urjaman/frser-m328lpcspi/README.md

frser-m328lpcspi
================

Flashrom serprog device code for LPC/FWH + SPI on an atmega328p at 5V.

### Troubleshooting

Note that the flasher has a small interactive debug interface. This is
available on the serial terminal if a space character is sent.
Enter `?` to see available commands.
