urjaman/frser-m328lpcspi/hardware/schematic.png

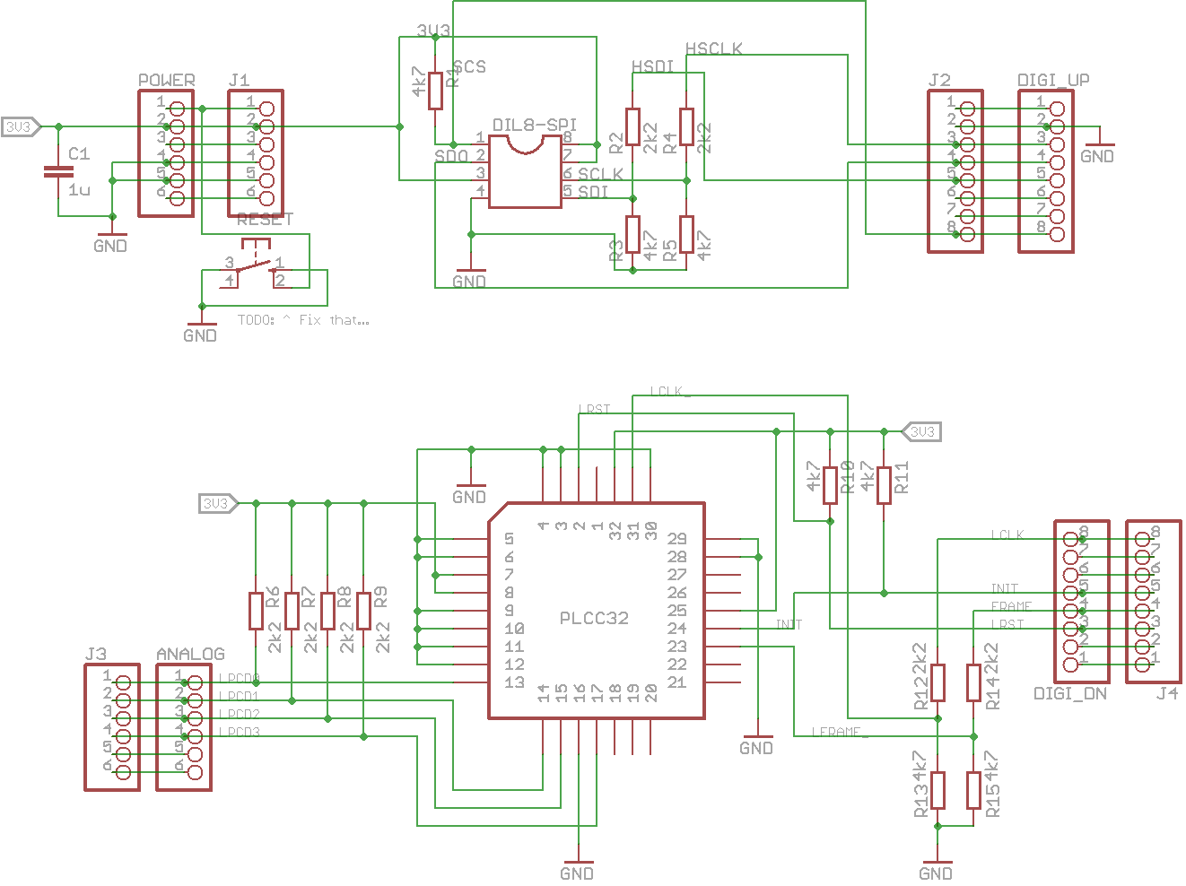
hardware/schematic.png
