urjaman/frser-m328lpcspi/hardware/duinolpcfwhspi.brd

## EAGLE design hardware/duinolpcfwhspi.brd (2015-04-25)

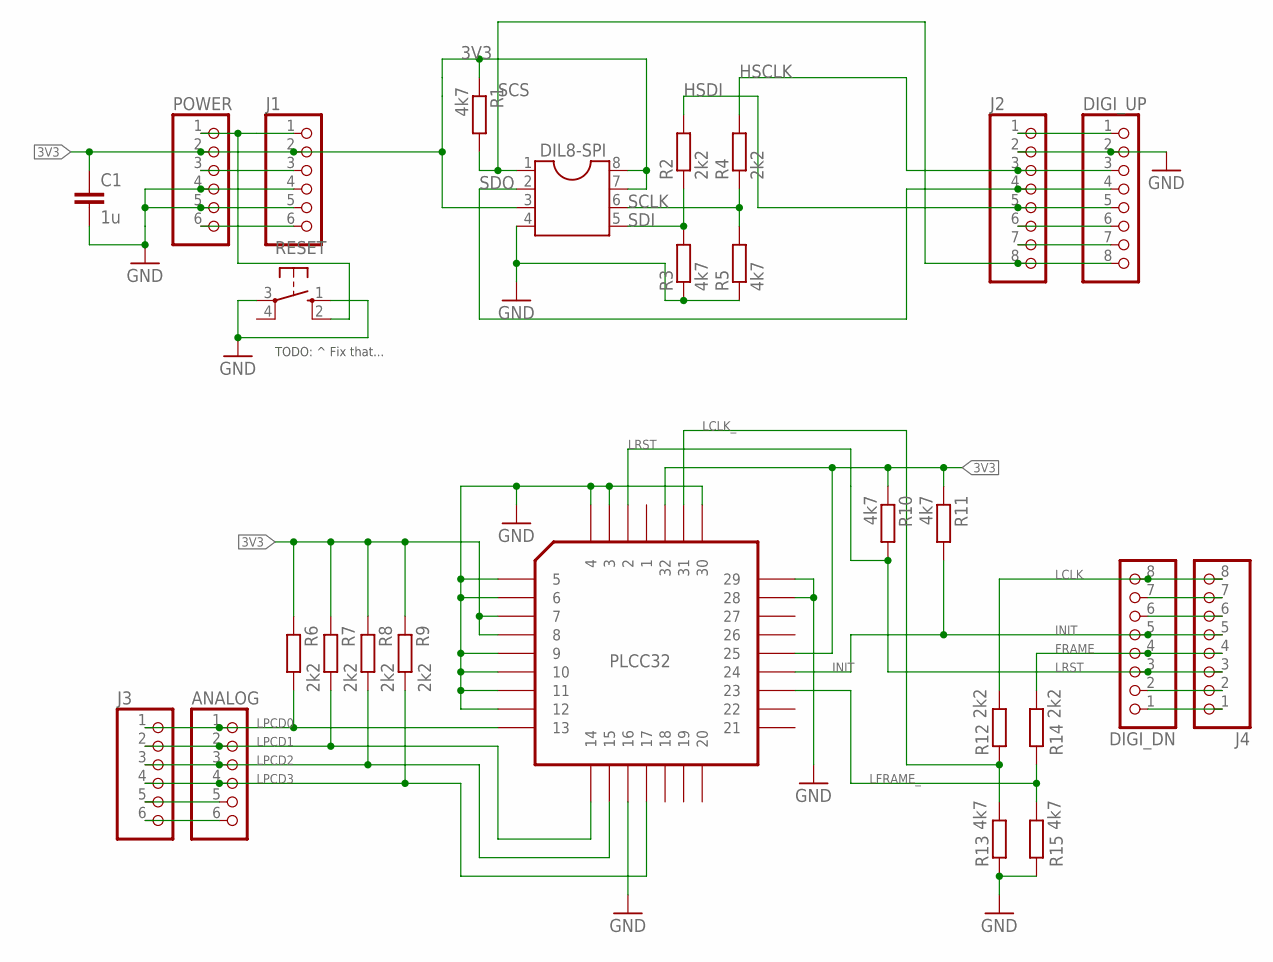
[picture p2: schematic duinolpcfwhspi.sch]

Parts:
ANALOG: PINHD-1X6; 1X06
C1: 1u; C025-025X050
DIGI_DN: PINHD-1X8TH; 1X08-TH
DIGI_UP: PINHD-1X8TH; 1X08-TH
DIL8-SPI: DIL8; DIL08
J1, J3: PINHD-1X6; 1X06
J2, J4: PINHD-1X8TH; 1X08-TH
PLCC32: PLCC32; PLCC-S32
POWER: PINHD-1X6; 1X06
R1, R3, R5, R10, R11, R13, R15: 4k7; 0207/2V
R2, R4, R6, R7, R8, R9, R12, R14: 2k2; 0207/2V
RESET: 10-XX; B3F-10XX

Connections:
3V3: C1.1, DIL8-SPI.3, DIL8-SPI.7, DIL8-SPI.8, J1.2, PLCC32.7, PLCC32.8, PLCC32.25, PLCC32.32, POWER.2, R1.1, R6.1, R7.1, R8.1, R9.1, R10.1, R11.1
5V0: J1.3, POWER.3
AREF: DIGI_UP.1, J2.1
FRAME: DIGI_DN.4, J4.4, R14.2
GND: C1.2, DIGI_UP.2, DIL8-SPI.4, J1.4, J1.5, J2.2, PLCC32.3, PLCC32.4, PLCC32.5, PLCC32.6, PLCC32.9, PLCC32.10, PLCC32.11, PLCC32.12, PLCC32.16, PLCC32.28, PLCC32.29, PLCC32.30, POWER.4, POWER.5, R3.1, R5.1, R13.1, R15.1, RESET.1 (S), RESET.3
HSCLK: DIGI_UP.3, J2.3, R4.2
HSDI: DIGI_UP.5, J2.5, R2.2
INIT: DIGI_DN.5, J4.5, PLCC32.24, R11.2
LCLK: DIGI_DN.8, J4.8, R12.2
LCLK_: PLCC32.31, R12.1, R13.2
LFRAME_: PLCC32.23, R14.1, R15.2
LPCD0: ANALOG.1, J3.1, PLCC32.13, R6.2
LPCD1: ANALOG.2, J3.2, PLCC32.14, R7.2
LPCD2: ANALOG.3, J3.3, PLCC32.15, R8.2
LPCD3: ANALOG.4, J3.4, PLCC32.17, R9.2
LRST: DIGI_DN.3, J4.3, PLCC32.2, R10.2
PB1: DIGI_UP.7, J2.7
PB2: DIGI_UP.6, J2.6
PC4: ANALOG.5, J3.5
PC5: ANALOG.6, J3.6
PD0: DIGI_DN.1, J4.1
PD1: DIGI_DN.2, J4.2
PD5: DIGI_DN.6, J4.6
PD6: DIGI_DN.7, J4.7
RESET: J1.1, POWER.1, RESET.2 (S1)
SCLK: DIL8-SPI.6, R4.1, R5.2
SCS: DIGI_UP.8, DIL8-SPI.1, J2.8, R1.2
SDI: DIL8-SPI.5, R2.1, R3.2
SDO: DIGI_UP.4, DIL8-SPI.2, J2.4
VIN: J1.6, POWER.6

Notes on the sheet:
TODO: ^ Fix that...

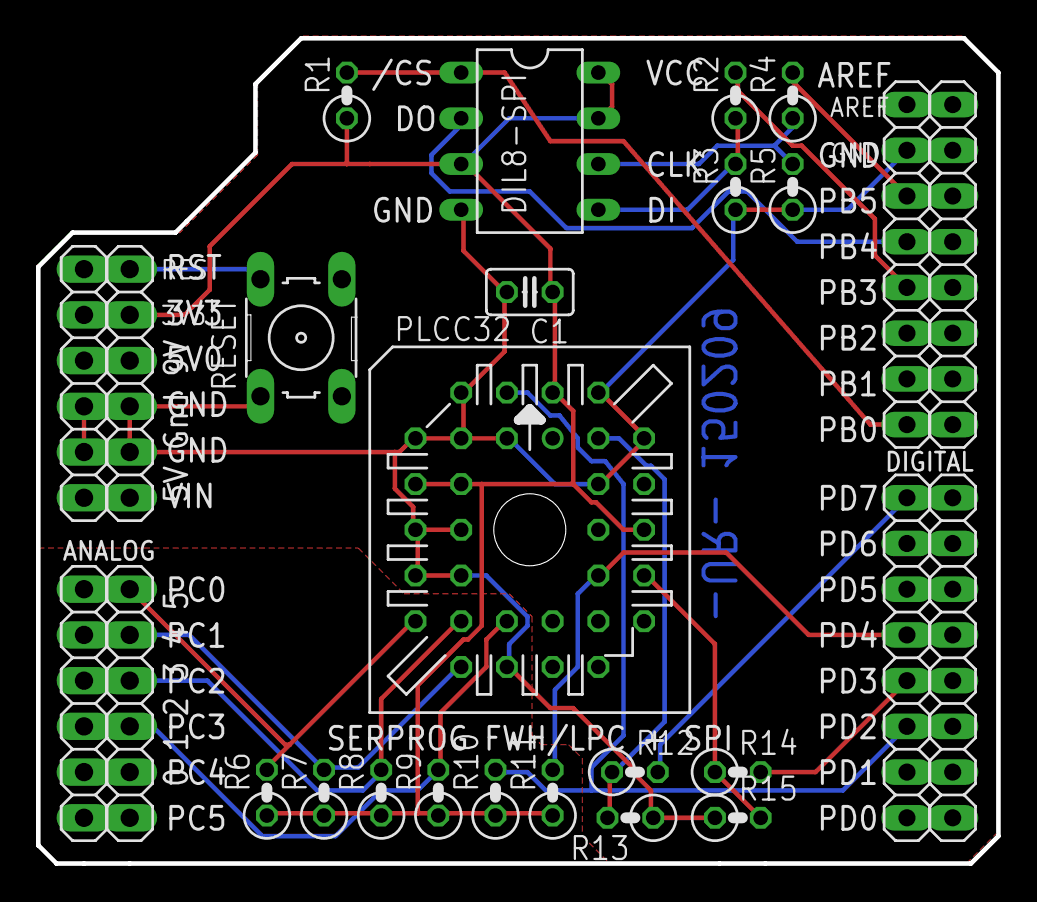
[picture p3: board duinolpcfwhspi.brd from above]

Board: 2 copper layers, 53.3 x 45.8 mm, 27 parts (0 on the bottom side), 30 nets.
