urjaman/frser-m328lpcspi/(threads)

Thread 1 (2020-07-05):

Using a FTDI FT232R so it runs on 3.3v without needing the level translation components

BaltasarParreira, 2020-07-05:
Hi is it possible just changing on main.h this:
`#define F_CPU 16000000`
to
`#define F_CPU 12000000`

so the Arduino runs on 3.3v as specified here [Arduino flasher 3.3v](https://www.flashrom.org/Arduino_flasher_3.3v) without needing the level translation components ?

BaltasarParreira, 2020-07-06:
Answering myself I just found out that not changing the main.h, but using the FTDI for power Arduino with 3.3v and connection it to USB the flashrom tool identifies correctly the Arduino/programmer.

Even further... I tested changing the baud rate to 2000000 since the FTDI can handle It and also flashrom works ok identifying the serprog type programmer.

Next step is wiring everything with a real flash chip and see if it works normal as suppose to be. ; )
I'll post my findings here after finishing all tests.

xloem, 2022-04-04:
@BaltasarParreira how did it end up going?
