urjaman/frser-m328lpcspi/main.c

/*
 * This file is part of the frser-m328lpcspi project.
 *
 * Copyright (C) 2010 Urja Rannikko <urjaman@gmail.com>
 *
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
 * You should have received a copy of the GNU General Public License
 * along with this program; if not, write to the Free Software
 * Foundation, Inc., 51 Franklin St, Fifth Floor, Boston, MA  02110-1301 USA
 */

#include "main.h"
#include "uart.h"
#include "flash.h"
#include "frser.h"


int main(void) {
	cli();
	flash_portclear(); /* Abuse flash.c to give us PORT defaults. */
	uart_init();
	frser_main();
}
