urjaman/frser-m328lpcspi/commands.c

/*
 * This file is part of the frser-m328lpcspi project.
 *
 * Copyright (C) 2013 Urja Rannikko <urjaman@gmail.com>
 *
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
 * You should have received a copy of the GNU General Public License
 * along with this program; if not, write to the Free Software
 * Foundation, Inc., 51 Franklin St, Fifth Floor, Boston, MA  02110-1301 USA
 */

#include "main.h"
#include "uart.h"
#include "console.h"
#include "lib.h"
#include "appdb.h"
#include "flash.h"
#include "ciface.h"
#include "spilib.h"
#include "lpcfwh.h"
#include "frser.h"
#include "nibble.h"

/* This is for allowing the code to fit in 16k for the atmega168p. */
/* We optimize all of the unnecessary crap in Os instead of -O3 :P */
#pragma GCC optimize ("Os")
#pragma GCC optimize ("no-tree-switch-conversion")

static void sendcrlf(void) {
	sendstr_P(PSTR("\r\n"));
}

void echo_cmd(void) {
	unsigned char i;
	for (i=1;i<token_count;i++) {
		sendstr(tokenptrs[i]);
		SEND(' ');
	}
}

unsigned long int calc_opdo(unsigned long int val1, unsigned long int val2, unsigned char *op) {
	switch (*op) {
		case '+':
			val1 += val2;
			break;
		case '-':
			val1 -= val2;
			break;
		case '*':
			val1 *= val2;
			break;
		case '/':
			val1 /= val2;
			break;
		case '%':
			val1 %= val2;
			break;
		case '&':
			val1 &= val2;
			break;
		case '|':
			val1 |= val2;
			break;

		case '<':
			val1 = val1 << val2;
			break;

		case '>':
			val1 = val1 >> val2;
			break;
	}
	return val1;
}

void luint2outdual(unsigned long int val) {
	unsigned char buf[11];
	luint2str(buf,val);
	sendstr(buf);
	sendstr_P(PSTR(" ("));
	luint2xstr(buf,val);
	sendstr(buf);
	sendstr_P(PSTR("h) "));
}

unsigned long int closureparser(unsigned char firsttok, unsigned char*ptr) {
	unsigned char *op=NULL;
	unsigned char i,n;
	unsigned long int val1, val2;
	*ptr = firsttok+1;
	if (token_count <= firsttok) return 0;
	val1 = astr2luint(tokenptrs[firsttok]);
	sendstr_P(PSTR("{ "));
	luint2outdual(val1);
	n=0;
	for(i=firsttok+1;i<token_count;i++) {
		if (n&1) {
			sendstr(op);
			SEND(' ');
			if (*(tokenptrs[i]) == '(') {
				val2 = closureparser((i+1),&i);
			} else {
				val2 = astr2luint(tokenptrs[i]);
				luint2outdual(val2);
			}
			val1 = calc_opdo(val1,val2,op);
		} else {
			if (*(tokenptrs[i]) == ')') {
				sendstr_P(PSTR("} "));
				*ptr = i+1;
				return val1;
			}
			op = tokenptrs[i];
		}
		n++;
	}
	return val1;
}

void calc_cmd(void) {
	unsigned char *op=NULL;
	unsigned char i,n;
	unsigned long int val1;
	unsigned long int val2;
	if (token_count < 2) return;

	if (*(tokenptrs[1]) == '(') {
		val1 = closureparser(2,&i);
	} else {
		val1 = astr2luint(tokenptrs[1]);
		luint2outdual(val1);
		i=2;
	}
	n=0;
	for (;i<token_count;i++) {
		if (n&1) {
			sendstr(op);
			SEND(' ');
			if (*(tokenptrs[i]) == '(') {
				val2 = closureparser((i+1),&i);
			} else {
				val2 = astr2luint(tokenptrs[i]);
				luint2outdual(val2);
			}
			val1 = calc_opdo(val1,val2,op);
		} else {
			op = tokenptrs[i];
		}
		n++;
	}
	sendstr_P(PSTR("= "));
	luint2outdual(val1);
}

void help_cmd(void) {
	unsigned char i;
	const struct command_t * ctptr;
	PGM_P name;
	for(i=0;;i++) {
		ctptr = &(appdb[i]);
		name = (PGM_P)pgm_read_word(&(ctptr->name));
		if (!name) break;
		sendstr_P(name);
		SEND(' ');
	}
}

void frser_last_op_cmd(void) {
	luint2outdual(get_last_op());
}


// Returns Vendor (LOW) and Device (High) ID
unsigned int identify_flash(void) {
	unsigned int rv;
	unsigned char device;
	unsigned char vendor;

	flash_write(0x5555,0xAA);
	_delay_us(10);
	flash_write(0x2AAA,0x55);
	_delay_us(10);
	flash_write(0x5555,0x90);
	_delay_ms(10);
	device = flash_read(1);
	vendor = flash_read(0);
	rv = ((device<<8)|(vendor));
	flash_write(0x5555,0xAA);
	_delay_us(10);
	flash_write(0x2AAA,0x55);
	_delay_us(10);
	flash_write(0x5555,0xF0);
	_delay_ms(10);
	return rv;
}


void flash_readsect_cmd(void) {
	unsigned char i,d,z;
	unsigned char buf[3];
	unsigned char dbuf[16];
	unsigned long int addr;
	if (strlen((char*)tokenptrs[1]) != 4) return;
	addr = (((unsigned long int)xstr2uchar(tokenptrs[1]))<<16);
	addr |= (((unsigned long int)xstr2uchar((tokenptrs[1]+2)))<<8);
	i=0;
	while(1) {
		d = flash_read(addr|i);
		uchar2xstr(buf,d);
		sendstr(buf);
		SEND(' ');
		dbuf[i&0x0F] = d;
		if ((i & 0x0F) == 0x0F) {
			for(z=0;z<16;z++) {
				if (((dbuf[z]) < 32) || (dbuf[z] == 127) || (dbuf[z] > 127))
					SEND('.');
				else SEND(dbuf[z]);
			}
			sendcrlf();
		}
		i++;
		if (i == 0) break;
	}
	return;
}


void flash_proto_cmd(void) {
	uint8_t proto = flash_get_proto();
	sendstr_P(PSTR("PROTO: "));
	switch (proto) {
		case 0:
		sendstr_P(PSTR("NONE"));
		break;

		case CHIP_BUSTYPE_PARALLEL:
		sendstr_P(PSTR("PARALLEL"));
		break;

		case CHIP_BUSTYPE_LPC:
		sendstr_P(PSTR("LPC"));
		break;

		case CHIP_BUSTYPE_FWH:
		sendstr_P(PSTR("FWH"));
		break;

		case CHIP_BUSTYPE_SPI:
		sendstr_P(PSTR("SPI"));
		break;
	}
}

void flash_idchip_cmd(void) {
	unsigned char buf[5];
	unsigned int chipid;
	chipid = identify_flash();
	uint2xstr(buf,chipid);
	sendstr(buf);
	return;
}

static void sendstr_no(void) {
	sendstr_P(PSTR(" NO"));
}

void spi_id_cmd(void) {
	uint8_t buf[4];
	uint8_t idb[3];
	spi_init_cond();
	sendstr_P(PSTR("RDID:"));
	buf[0] = ' ';
	if (spi_probe_rdid(idb)) {
		uchar2xstr(buf+1,idb[0]);
		sendstr(buf);
		uchar2xstr(buf+1,idb[1]);
		sendstr(buf);
		uchar2xstr(buf+1,idb[2]);
		sendstr(buf);
	} else {
		sendstr_no();
	}
	sendstr_P(PSTR(" REMS:"));
	if (spi_probe_rems(idb)) {
		uchar2xstr(buf+1,idb[0]);
		sendstr(buf);
		uchar2xstr(buf+1,idb[1]);
		sendstr(buf);
	} else {
		sendstr_no();
	}
	sendstr_P(PSTR(" RES:"));
	if (spi_probe_res(idb)) {
		uchar2xstr(buf+1,idb[0]);
		sendstr(buf);
	} else {
		sendstr_no();
	}
}

static void print_bool(uint8_t v) {
	if (v) sendstr_P(PSTR("TRUE"));
	else sendstr_P(PSTR("FALSE"));
}

void spi_test_cmd(void) {
	flash_set_safe();
	print_bool(spi_test());
}


void lpc_test_cmd(void) {
	flash_set_safe();
	print_bool(lpc_test());
}

void fwh_test_cmd(void) {
	flash_set_safe();
	print_bool(fwh_test());
}

void flash_sproto_cmd(void)
{
	uint8_t p = SUPPORTED_BUSTYPES;
	if (token_count==2) {
		switch (tokenptrs[1][0]) {
			default:
				break;
			case 's':
			case 'S':
				p = CHIP_BUSTYPE_SPI;
				break;
			case 'p':
			case 'P':
				p = CHIP_BUSTYPE_PARALLEL;
				break;
			case 'l':
			case 'L':
				p = CHIP_BUSTYPE_LPC;
				break;
			case 'f':
			case 'F':
				p = CHIP_BUSTYPE_FWH;
				break;
		}
	}
	flash_select_protocol(p);
}

static uint8_t pin_test_state = 0;
void pin_test_cmd(void)
{
	if (flash_get_proto()) {
		flash_select_protocol(0);
		sendstr_P(PSTR("-> REENABLE BUS WITH SPROTO <-"));
		sendcrlf();
		sendcrlf();
	}
	spi_uninit();

	switch (pin_test_state) {
	case 0:
		sendstr_P(PSTR("SPI pin 1 CS slow pullup to 3V"));
		spi_deselect();

		sendcrlf();
		sendstr_P(PSTR("SPI pin 2 DO internal pullup"));
		SPI_DDR &= ~_BV(SPI_DO);
		SPI_PORT |= _BV(SPI_DO);

		sendcrlf();
		sendstr_P(PSTR("SPI pin 5 DI driven, divided to 3V"));
		SPI_DDR |= _BV(SPI_DI);
		SPI_PORT |= _BV(SPI_DI);

		sendcrlf();
		sendstr_P(PSTR("SPI pin 6 CLK driven, divided to 3V"));
		SPI_DDR |= _BV(SPI_CLK);
		SPI_PORT |= _BV(SPI_CLK);

		sendcrlf();
		sendstr_P(PSTR("LPC pin 2 RST slow pullup to 3V"));
		RST_DDR &= ~_BV(RST);

		sendcrlf();
		sendstr_P(PSTR("LPC pin 23 FRAME driven, divided to 3V"));
		FRAME_DDR |= _BV(FRAME);
		FRAME_PORT |= _BV(FRAME);

		sendcrlf();
		sendstr_P(PSTR("LPC pin 24 INIT slow pullup to 3V"));
		INIT_DDR &= ~_BV(INIT);

		sendcrlf();
		sendstr_P(PSTR("LPC pin 31 CLK driven, divided to 3V"));
		CLK_DDR |= _BV(CLK);
		CLK_PORT |= _BV(CLK);

		sendcrlf();
		sendstr_P(PSTR("LPC pins 13,14,15,17 NIBBLE pullup to 3V"));
		NIBBLE_DDR = 0;

		pin_test_state = 1;
		break;

	case 1:
		sendstr_P(PSTR("SPI CS DO DI CLK driven 0V"));
		spi_select();
		SPI_PORT &= ~_BV(SPI_DI);
		SPI_DDR |= _BV(SPI_DI);
		SPI_PORT &= ~_BV(SPI_DO);
		SPI_DDR |= _BV(SPI_DO);
		SPI_PORT &= ~_BV(SPI_CLK);
		SPI_DDR |= _BV(SPI_CLK);

		sendcrlf();
		sendstr_P(PSTR("SPI pin 4 GND wired 0V"));
		sendcrlf();
		sendstr_P(PSTR("SPI pins 3,7,8 3V3 wired 3V"));

		sendcrlf();
		sendstr_P(PSTR("LPC RST FRAME INIT CLK NIBBLE driven 0V"));
		RST_DDR |= _BV(RST);
		RST_PORT &= ~_BV(RST);
		FRAME_DDR |= _BV(FRAME);
		FRAME_PORT &= ~_BV(FRAME);
		INIT_DDR |= _BV(INIT);
		INIT_PORT &= ~_BV(INIT);
		CLK_DDR |= _BV(CLK);
		CLK_PORT &= ~_BV(CLK);
		NIBBLE_DDR = 0xF;

		sendcrlf();
		sendstr_P(PSTR("LPC pins 3-6,9-12,16,28-30 GND wired 0V"));
		sendcrlf();
		sendstr_P(PSTR("LPC pins 7,8,25,32 3V3 wired 3V"));

	default:
		pin_test_state = 0;
	}
}

#pragma GCC reset_options
