urjaman/frser-m328lpcspi/uart.c

/*
 * This file is part of the frser-m328lpcspi project.
 *
 * Copyright (C) 2009,2011,2013 Urja Rannikko <urjaman@gmail.com>
 *
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
 * You should have received a copy of the GNU General Public License
 * along with this program; if not, write to the Free Software
 * Foundation, Inc., 51 Franklin St, Fifth Floor, Boston, MA  02110-1301 USA
 */

#include "main.h"
#include "uart.h"
#include "flash.h"

/* This is 2s of our 16-bit timer. */
#define UART_TIMEOUT (F_CPU/512)

// UART MODULE START
typedef uint16_t urxbufoff_t;
typedef uint8_t utxbufoff_t;
static uint8_t volatile uart_rcvbuf[UART_BUFLEN];
static urxbufoff_t volatile uart_rcvwptr;
static urxbufoff_t uart_rcvrptr;

#ifndef UART_POLLED_TX
static uint8_t volatile uart_sndbuf[UARTTX_BUFLEN];
static utxbufoff_t volatile uart_sndwptr;
static utxbufoff_t volatile uart_sndrptr;
#endif

ISR(USART_RX_vect) {
	uint8_t d = UDR0;
	urxbufoff_t reg = uart_rcvwptr;
	uart_rcvbuf[reg] = d;
	reg++;
	if(reg==UART_BUFLEN) reg = 0;
	uart_rcvwptr = reg;
}

static jmp_buf *uart_timeout_jmp = 0;

void uart_set_timeout(jmp_buf *buf) {
	uart_timeout_jmp = buf;
}

#ifndef UART_POLLED_TX
ISR(USART_UDRE_vect) {
	utxbufoff_t reg = uart_sndrptr;
	if (uart_sndwptr != reg) {
		UDR0 = uart_sndbuf[reg++];
		if (reg==UARTTX_BUFLEN) reg = 0;
		uart_sndrptr = reg;
		return;
	} else {
		UCSR0B &= ~_BV(5);
		return;
	}
}
#endif

uint8_t uart_isdata(void) {
	if (uart_rcvwptr != uart_rcvrptr) { return 1; }
	else { return 0; }
}

static void uart_wait_start(void) {
	TCNT1 = 0; /* Clear timer. */
}

static void uart_waiting(void) {
	/* Since we have no timer interrupt ticking in the background, we currently
	   cant go to sleep while waiting for UART data and have our no-data timeout work.
	   I'm too lazy to fix this (since it is only a power usage thing...) */
	uint8_t iclk = flash_idle_clock();
	if (uart_timeout_jmp) {
		uint16_t v = TCNT1;
		if (v>UART_TIMEOUT) {
			longjmp(*uart_timeout_jmp,1);
		}
	} else if (!iclk) { /* Only sleep if we _dont_ have a clock to toggle. */
		/* In case of no timeout enabled, we can do a proper sleep though. */
		cli();
		if (uart_rcvwptr == uart_rcvrptr) { /* Race condition check */
			sleep_enable();
			sei();
			sleep_cpu();
			sleep_disable();
		}
		sei();
	}
}

uint8_t uart_peek(void) {
	uart_wait_start();
	while (!uart_isdata()) uart_waiting();
	return uart_rcvbuf[uart_rcvrptr];
}

uint8_t uart_recv(void) {
	urxbufoff_t reg;
	uint8_t val;
	uart_wait_start();
	while (!uart_isdata()) uart_waiting();
	reg = uart_rcvrptr;
	val = uart_rcvbuf[reg++];
	if(reg==UART_BUFLEN) reg = 0;
	uart_rcvrptr = reg;
	return val;
}

void uart_send(uint8_t val) {
#ifndef UART_POLLED_TX
	utxbufoff_t reg;
	while (uart_sndwptr+1==uart_sndrptr || (uart_sndwptr+1==UARTTX_BUFLEN && !uart_sndrptr)); // wait for space in buf
	cli();
	reg = uart_sndwptr;
	UCSR0B |= _BV(5); // make sure the transmit int is on
	uart_sndbuf[reg++] = val; // add byte to the transmit queue
	if(reg==UARTTX_BUFLEN) reg = 0;
	uart_sndwptr = reg;
	sei();
#else
	while (!(UCSR0A & _BV(UDRE0))); // wait for space in reg
	UDR0 = val;
#endif
}

void uart_init(void) {
	cli();
	TCCR1A = 0;
	TCCR1B = 5; // clkIO/1024

#include <util/setbaud.h>
// Assuming uart.h defines BAUD
	uart_rcvwptr = 0;
	uart_rcvrptr = 0;
#ifndef UART_POLLED_TX
	uart_sndwptr = 0;
	uart_sndrptr = 0;
#endif
	UBRR0H = UBRRH_VALUE;
	UBRR0L = UBRRL_VALUE;
	UCSR0C = 0x06; // Async USART,No Parity,1 stop bit, 8 bit chars
	UCSR0A &= 0xFC;
#if USE_2X
	UCSR0A |= (1 << U2X0);
#endif
#ifndef UART_POLLED_TX
	UCSR0B = 0xB8; // RX complete interrupt enable, UDRE int en, Receiver & Transmitter enable
#else
	UCSR0B = 0x98; // RXC int, receiver adn transmitter
#endif
	sei();
}

void uart_wait_txdone(void) {
#ifndef UART_POLLED_TX
	while (uart_sndwptr != uart_sndrptr);
#endif
}
