urjaman/frser-m328lpcspi/console.c

/*
 * This file is part of the frser-m328lpcspi project.
 *
 * Copyright (C) 2013 Urja Rannikko <urjaman@gmail.com>
 *
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
 * You should have received a copy of the GNU General Public License
 * along with this program; if not, write to the Free Software
 * Foundation, Inc., 51 Franklin St, Fifth Floor, Boston, MA  02110-1301 USA
 */

// CONSOLE SUBSYSTEM
#include "main.h"
#include "uart.h"
#include "console.h"
#include "ciface.h"
#include "frser.h"

#define CR 0x0D
#define LF 0x0A
#define BS 0x08
#define DEL 0x7F
#define SPACE 0x20

uint8_t getline(unsigned char *buf, unsigned char len) {
	unsigned char val,i;
	memset(buf,0,len);
	for(i=0;i<len;i++) {
		val = PEEK();
		if ((val==S_CMD_NOP)||(val==S_CMD_Q_IFACE)||
			(val==S_CMD_SYNCNOP)) return 1; // EXIT
		val = RECEIVE();
		if (((val == BS)||(val == DEL))&&(i)) { SEND(BS); SEND(SPACE); SEND(BS); i = i-2; continue; }; // Understand BS or DEL
		if (val == CR) { SEND(CR); SEND(LF); buf[i] = 0; break; }; // Understand LF
		if ((val < 32)||(val == DEL)) { i--; continue; };
		if (val == 255) { RECEIVE(); RECEIVE(); i--; continue; }; // Filter TELNET options
		buf[i] = val;
		SEND(val);
		}
	buf[len-1] = 0;
	return 0;
}


void sendstr_P(PGM_P str) {
	unsigned char val;
	for(;;) {
		val = pgm_read_byte(str);
		if (val) SEND(val);
		else break;
		str++;
		}
	}

void sendstr(const unsigned char * str) {
	unsigned char val;
	for(;;) {
		val = *str;
		if (val) SEND(val);
		else break;
		str++;
		}
	}

unsigned char* scanfor_notspace(unsigned char *buf) {
	for (;;) {
		if (!(*buf)) return buf;
		if (!isspace(*buf)) return buf;
		buf++;
	}
}

unsigned char* scanfor_space(unsigned char *buf) {
	for (;;) {
		if (!(*buf)) return buf;
		if (isspace(*buf)) return buf;
		buf++;
	}
	}

static unsigned char count_tokens(unsigned char *rcvbuf) {
	unsigned char tokens=0;
	for (;;) {
		rcvbuf = scanfor_notspace(rcvbuf);
		if(!(*rcvbuf)) break;
		tokens++;
		rcvbuf = scanfor_space(rcvbuf);
		if (!(*rcvbuf)) break;
	}
	return tokens;
	}

void tokenize(unsigned char *rcvbuf,unsigned char** ptrs, unsigned char* tkcntptr) {
	unsigned char i;
	unsigned char tokens;

	tokens = count_tokens(rcvbuf);
	if (tokens > MAXTOKENS) tokens = MAXTOKENS;
	if (tkcntptr) *tkcntptr = tokens;

	for (i=0;i<tokens;i++) {
		rcvbuf = scanfor_notspace(rcvbuf);
		if (!(*rcvbuf)) break;
		ptrs[i] = rcvbuf;
		rcvbuf = scanfor_space(rcvbuf);
		if (*rcvbuf) { *rcvbuf = 0; rcvbuf++; };
	}
	if (ptrs[0]) strupr((char*)ptrs[0]);
	return;
}
