urjaman/frser-m328lpcspi/(commit log)

2015-03-08 Convert to M328 LPC/FWH + SPI firmware
2015-03-08 Include hardware (the board) description files
    [duinolpcfwhspi.brd]
2015-03-10 Enable -O3 (and fix one thing gcc found at -O3).
    This makes LPC go from read at 42 kB/s to 73 kB/s.
    And a full chip rewrite for 512k is ~4.5 min now.
    It also blows up the firmware size, but its not like we
    have any other use for it right now :)
    [commands.c]
2015-03-21 make uart buffer sizes auto-scale with RAM size so you dont need to mess with them
2015-03-23 DUH. That was stupid. Fix flash.c PORTB settings...
    [flash.c]
2015-03-23 spi: cleanup the speed-setting code a bit and re-arrange a bit
    in preparation of splitting hardware-dependent and independent
    parts out of each other
2015-03-23 use the spi support that was copied/moved into libfrser
2015-04-25 hardware documentation: add schematic i just hacked together
    [duinolpcfwhspi.brd, duinolpcfwhspi.sch]
2015-05-23 uart: optimize ISR code for compiler to do a better job
    Results in 8 (my guesstimate) less cycles (2 less pushed regs)
    in the ISR, thus 10% more time for other stuff during RX at 2Mbps.
    Actually won 6s in flashing 512k LPC, but whatever.
2015-05-23 Makefile: allow overriding serial device from command line
2023-02-25 add wiring voltage tests for spi pins
