urjaman/frser-m328lpcspi/(notices)

Notices in the files:
flash.c:
This program is free software; you can redistribute it and/or modify
it under the terms of the GNU General Public License as published by
the Free Software Foundation; either version 2 of the License, or
(at your option) any later version.
nibble.c:
the Free Software Foundation, either version 3 of the License, or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
